JakariaSami/stm32_motor_pid_ros2/Core/Src/main.c

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
/* Includes ------------------------------------------------------------------*/
#include "main.h"
#include "eth.h"
#include "i2c.h"
#include "tim.h"
#include "usart.h"
#include "usb_otg.h"
#include "gpio.h"

/* USER CODE BEGIN Includes */
#include "stdio.h"
#include <stdlib.h>
/* USER CODE END Includes */


/* USER CODE BEGIN PV */
int32_t count = 0;

volatile float setpoint = 50.0f;
float Kp = 100.0f;
float Ki = 4.0f;
float Kd = 0.0f;

volatile float measured_speed = 0.0f;
volatile float pwm_output = 0.0f;
float integral = 0.0f;
float prev_error = 0.0f;
uint16_t prev_count = 0;

uint8_t rx_byte;
char rx_buffer[16];
uint8_t rx_index = 0;
/* USER CODE END PV */

void SystemClock_Config(void);
static void MPU_Config(void);
/**
  * @brief  The application entry point.
  * @retval int
  */
int main(void)
{

  /* MPU Configuration--------------------------------------------------------*/
  MPU_Config();

  /* MCU Configuration--------------------------------------------------------*/

  /* Reset of all peripherals, Initializes the Flash interface and the Systick. */
  HAL_Init();

  /* Configure the system clock */
  SystemClock_Config();

  /* Initialize all configured peripherals */
  MX_GPIO_Init();
  MX_ETH_Init();
  MX_I2C1_Init();
  MX_USART3_UART_Init();
  MX_USB_OTG_FS_PCD_Init();
  MX_TIM3_Init();
  MX_TIM1_Init();
  MX_TIM4_Init();
  /* USER CODE BEGIN 2 */
  HAL_TIM_Encoder_Start(&htim3, TIM_CHANNEL_ALL);
  HAL_TIM_PWM_Start(&htim1, TIM_CHANNEL_1);
  HAL_TIM_Base_Start_IT(&htim4);
  HAL_UART_Receive_IT(&huart3, &rx_byte, 1);
  /* USER CODE END 2 */

  /* Infinite loop */
  /* USER CODE BEGIN WHILE */
  while (1)
  {
    /* USER CODE END WHILE */

    /* USER CODE BEGIN 3 */
	  char msg[64];
	  uint32_t t = HAL_GetTick();
	  int len = snprintf(msg, sizeof(msg), "%lu,%.1f,%.1f\r\n", t, setpoint, measured_speed);
	  HAL_UART_Transmit(&huart3, (uint8_t*)msg, len, 100);
	  HAL_Delay(20);
  }
  /* USER CODE END 3 */
}

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
/* USER CODE BEGIN 4 */
void HAL_UART_RxCpltCallback(UART_HandleTypeDef *huart) {
    if (huart->Instance == USART3) {
    	if (rx_byte == '\n' || rx_byte == '\r') {
    		rx_buffer[rx_index] = '\0';
            if (rx_index > 0) {
                float new_setpoint = atof(rx_buffer);

                if (new_setpoint > 180.0f) new_setpoint = 180.0f;
                if (new_setpoint < -180.0f) new_setpoint = -180.0f;
                setpoint = new_setpoint;
            }
            rx_index = 0;
        } else if (rx_index < sizeof(rx_buffer) - 1) {
            rx_buffer[rx_index++] = rx_byte;
        }

        HAL_UART_Receive_IT(&huart3, &rx_byte, 1);
    }
}

void HAL_TIM_PeriodElapsedCallback(TIM_HandleTypeDef *htim) {
	if (htim->Instance == TIM4) {
		uint16_t current_count = __HAL_TIM_GET_COUNTER(&htim3);

		int16_t delta = (int16_t)(current_count - prev_count);
		measured_speed = (float)delta;
		prev_count = current_count;

		float error = setpoint - measured_speed;

		// Anti-windup logic, so that the integral doesn't grow unbounded.
		if (integral > 3000.0f) integral = 3000.0f;
		if (integral < -3000.0f) integral = -3000.0f;

		float derivative = error - prev_error;
		prev_error = error;

		float output = (Kp * error) + (Ki * integral) + (Kd * derivative);
		pwm_output = output;

		if (output < 5399.0f && output > -5399.0f) {
			integral += error;
		}

		//Direction handling
		if (output >= 0) {
			HAL_GPIO_WritePin(IN1_GPIO_Port, IN1_Pin, GPIO_PIN_SET);
			HAL_GPIO_WritePin(IN2_GPIO_Port, IN2_Pin, GPIO_PIN_RESET);
		} else {
			HAL_GPIO_WritePin(IN1_GPIO_Port, IN1_Pin, GPIO_PIN_RESET);
			HAL_GPIO_WritePin(IN2_GPIO_Port, IN2_Pin, GPIO_PIN_SET);
			output = -output;   // only magnitude for PWM
		}

		// limiting the PWM to the valid range (0-5399).
		if (output > 5399.0f) output = 5399.0f;
		__HAL_TIM_SET_COMPARE(&htim1, TIM_CHANNEL_1, (uint16_t)output);
	}
}
/* USER CODE END 4 */

 /* MPU Configuration */

void MPU_Config(void)
{
  MPU_Region_InitTypeDef MPU_InitStruct = {0};

  /* Disables the MPU */
  HAL_MPU_Disable();

  /** Initializes and configures the Region and the memory to be protected
  */
  MPU_InitStruct.Enable = MPU_REGION_ENABLE;
  MPU_InitStruct.Number = MPU_REGION_NUMBER0;
  MPU_InitStruct.BaseAddress = 0x0;
  MPU_InitStruct.Size = MPU_REGION_SIZE_4GB;
  MPU_InitStruct.SubRegionDisable = 0x87;
  MPU_InitStruct.TypeExtField = MPU_TEX_LEVEL0;
  MPU_InitStruct.AccessPermission = MPU_REGION_NO_ACCESS;
  MPU_InitStruct.DisableExec = MPU_INSTRUCTION_ACCESS_DISABLE;
  MPU_InitStruct.IsShareable = MPU_ACCESS_SHAREABLE;
  MPU_InitStruct.IsCacheable = MPU_ACCESS_NOT_CACHEABLE;
  MPU_InitStruct.IsBufferable = MPU_ACCESS_NOT_BUFFERABLE;

  HAL_MPU_ConfigRegion(&MPU_InitStruct);
  /* Enables the MPU */
  HAL_MPU_Enable(MPU_PRIVILEGED_DEFAULT);

}

/**
  * @brief  This function is executed in case of error occurrence.
  * @retval None
  */
void Error_Handler(void)
{
  /* USER CODE BEGIN Error_Handler_Debug */
  /* User can add his own implementation to report the HAL error return state */
  __disable_irq();
  while (1)
  {
  }
  /* USER CODE END Error_Handler_Debug */
}
#ifdef USE_FULL_ASSERT
/**
  * @brief  Reports the name of the source file and the source line number
  *         where the assert_param error has occurred.
  * @param  file: pointer to the source file name
  * @param  line: assert_param error line source number
  * @retval None
  */
void assert_failed(uint8_t *file, uint32_t line)
{
  /* USER CODE BEGIN 6 */
  /* User can add his own implementation to report the file name and line number,
     ex: printf("Wrong parameters value: file %s on line %d\r\n", file, line) */
  /* USER CODE END 6 */
}
#endif /* USE_FULL_ASSERT */
